krepostnoy/brain-of-infrared-rework-station/kluch_5.2d/MENU__LCD2004.pdf

0 | 1 | 2 | 3 | 4 | 5 | 6 | 7 | 8 | 9 10 11 12 13 14 15 16 17 18 19
0 | 0 | b | r | a | i | n | o | f | I | R | s | t | a | t | i | o | n
1 | 1 | | v | 1 | . | 3 | . | 3 | | | | S | P | P | i | r | s | p
2 | 2 | f | o | r | u | m | . | a | m | p | e | r | k | a | . | r | u
3 | 3 | e | v | e | r | y | o | n | e | l | o | v | e | s | c | a | t | s | !
S | t | a | t | e | : | I | D | L | E | m | > | ( | * | . | * | ) | < | m
| N | a | m | e | : | | 1 | | | S | t | e | p | : | | 1
| T | h | S | P | : | | 1 | 8 | 0 | R | e | a | l | : | | 2 | 8
| B | h | S | P | : | | 1 | 6 | 0 | R | e | a | l | : | | 2 | 8
P | r | o | f | i | l | e | : | 1 | 0 | S | t | e | p | s | : | 4
P | r | o | f | i | l | e | : | 1 | 0 | | S | t | e | p | s | : | 4
B | o | t | H | e | a | t | e | r | | T | a | r | g | e | t | : | 1 | 6 | 0
P | r | o | f | i | l | e | : | 1 | 0 | | S | t | e | p | s | : | 4
B | o | t | H | e | a | t | e | r | | T | a | r | g | e | t | : | 1 | 6 | 0
T | o | p | S | t | e | p | : | 1 | | T | a | r | g | e | t | : | 1 | 8 | 0
P | r | o | f | i | l | e | : | 1 | 0 | | S | t | e | p | s | : | 4
B | o | t | H | e | a | t | e | r | | T | a | r | g | e | t | : | 1 | 6 | 0
T | o | p | S | t | e | p | : | 1 | | | | R | a | m | p | : | 1 | . | 0
P | r | o | f | i | l | e | : | 1 | 0 | | S | t | e | p | s | : | 4
B | o | t | H | e | a | t | e | r | | T | a | r | g | e | t | : | 1 | 6 | 0
T | o | p | S | t | e | p | : | 1 | | | D | w | e | l | l | : | 1 | 0
P | r | o | f | i | l | e | : | 1 | 0 | | S | t | e | p | s | : | 4
P | . | | I | . | | D | . | | | P | a | r | a | m | e | t | e | r | s
B | o | t | H | e | a | t | e | r | | | | | k | f | 2 | : | 6 | 0

заставка при вкл. станции

главный экран

ред. число шагов в профиле (1-4)

ред. уставки НИ профиля №1 (80-330°С)

ред. уставки в шаге №1 профиля №1 (0-255°С)

ред. скорость прироста температуры в шаге профиля (0,1-3,0°С/сек)

ред. длительности удержания уставки шага профиля (0-255сек)

ПИД НИ, ред. Kf2 для LongBottomPid(0-255) НЕ ИСПОЛЬЗУЕТСЯ

P | r | o | f | i | l | e | : | 1 | 0 | | S | t | e | p | s | : | 4
P | . | | I | . | | D | . | | | P | a | r | a | m | e | t | e | r | s
B | o | t | H | e | a | t | e | r | | | | | k | f | 2 | : | 6 | 0
P | : | 6 | | | | | I | : | | | | | | D | :
P | r | o | f | i | l | e | : | 1 | 0 | | S | t | e | p | s | : | 4
P | . | | I | . | | D | . | | | P | a | r | a | m | e | t | e | r | s
B | o | t | H | e | a | t | e | r | | | | | k | f | 2 | : | 6 | 0
P | : | 6 | | | | | I | : | 2 | 0 | | | | D | :
P | r | o | f | i | l | e | : | 1 | 0 | | S | t | e | p | s | : | 4
P | . | | I | . | | D | . | | | P | a | r | a | m | e | t | e | r | s
B | o | t | H | e | a | t | e | r | | | | | k | f | 2 | : | 6 | 0
P | : | 6 | | | | | I | : | 2 | 0 | | | | D | : | 4 | 0
P | r | o | f | i | l | e | : | 1 | 0 | | S | t | e | p | s | : | 4
P | . | | I | . | | D | . | | | P | a | r | a | m | e | t | e | r | s
T | o | p | H | e | a | t | e | r
P | : | 6 | | | | | I | : | | | | | | D | :
P | r | o | f | i | l | e | : | 1 | 0 | | S | t | e | p | s | : | 4
P | . | | I | . | | D | . | | | P | a | r | a | m | e | t | e | r | s
T | o | p | H | e | a | t | e | r
P | : | 6 | | | | | I | : | 2 | 0 | | | | D | :
P | r | o | f | i | l | e | : | 1 | 0 | | S | t | e | p | s | : | 4
P | . | | I | . | | D | . | | | P | a | r | a | m | e | t | e | r | s
T | o | p | H | e | a | t | e | r
P | : | 6 | | | | | I | : | 2 | 0 | | | | D | : | 4 | 0
P | r | o | f | i | l | e | : | 1 | 0 | | S | t | e | p | s | : | 4
P | o | w | e | r | | | | P | a | r | a | m | e | t | e | r | s
B | o | t | H | e | a | t | e | r | | P | W | R | | L | i | m | i | t | s
m | i | n | : | 0 | % | | | | | | | | m | a | x | :
P | r | o | f | i | l | e | : | 1 | 0 | | S | t | e | p | s | : | 4
P | o | w | e | r | | | P | a | r | a | m | e | t | e | r | s
B | o | t | H | e | a | t | e | r | | P | W | R | | L | i | m | i | t | s
m | i | n | : | 0 | % | | | | | | | | m | a | x | : | 9 | 9 | %
P | r | o | f | i | l | e | : | 1 | 0 | S | t | e | p | s | : | 4

ПИД НИ, ред. П(0-255)

ПИД НИ, ред. И(0-255)

ПИД НИ, ред. Д(0-255)

ПИД ВИ, ред. П(0-255)

ПИД ВИ, ред. И(0-255)

ПИД ВИ, ред. Д(0-255)

ред. ограничения мин. мощности НИ(0-50%)

ред. ограничения макс. мощности НИ(0-99%)

ред. уставки преднагрева для инерционного НИ(0-100°С)

P | o | w | e | r | | | P | a | r | a | m | e | t | e | r | s
T | o | p | S | t | e | p | : | 1 | | | T | o | p | P | o | w | e | r
m | i | n | : | 7 | 0 | | | | | | | | m | a | x | :
P | r | o | f | i | l | e | : | 1 | 0 | | S | t | e | p | s | : | 4
P | o | w | e | r | | | P | a | r | a | m | e | t | e | r | s
B | o | t | H | e | a | t | e | r | | P | W | R | | L | i | m | i | t | s
m | i | n | : | 7 | 0 | | | | | | | | m | a | x | : | 9 | 0 | %
P | r | o | f | i | l | e | : | 1 | 0 | | S | t | e | p | s | : | 4
P | o | w | e | r | | | P | a | r | a | m | e | t | e | r | s
T | o | p | S | t | e | p | : | 1 | | | T | o | p | P | o | w | e | r
m | i | n | : | 0 | % | | | | | | | | m | a | x | :
P | r | o | f | i | l | e | : | 1 | 0 | | S | t | e | p | s | : | 4
P | o | w | e | r | | | P | a | r | a | m | e | t | e | r | s
B | o | t | H | e | a | t | e | r | | P | W | R | | L | i | m | i | t | s
m | i | n | : | 0 | % | | | | | | | | m | a | x | : | 9 | 9 | %
P | r | o | f | i | l | e | : | 1 | 0 | S | t | e | p | s | : | 4

ред. число шагов в профиле (1-4) ред. мощности преднагрева для инерционного НИ(0-99%)

ред. ограничения мин. мощности ВИ(0-99%) в шаге профиля

ред. ограничение макс. мощности ВИ(0-99%) в шаге профиля
