krepostnoy/brain-of-infrared-rework-station/(threads)

Thread 1 (2023-04-05):

Предупреждения при компиляции

wzooroo, 2023-04-05:
`C:\ИК станция\kluch_5.2d\kluch_5.2d.ino:41:21: warning: extra tokens at end of #ifdef directive
C:\ИК станция\kluch_5.2d\kluch_5.2d.ino:44:21: warning: extra tokens at end of #ifdef directive
In file included from C:\ИК станция\kluch_5.2d\kluch_5.2d.ino:14:0:
C:\Users\home\Documents\Arduino\libraries\ClickBtnLong/ClickBtnLong.h:11:7: warning: extra qualification 'ClickBtnLong::' on member 'VerifiClick' [-fpermissive]
  bool ClickBtnLong::VerifiClick ();
       ^~~~~~~~~~~~

In file included from C:\Users\home\Documents\Arduino\libraries\ClickBtnLong\ClickBtnLong.cpp:4:0:
C:\Users\home\Documents\Arduino\libraries\ClickBtnLong\ClickBtnLong.h:11:7: warning: extra qualification 'ClickBtnLong::' on member 'VerifiClick' [-fpermissive]
  bool ClickBtnLong::VerifiClick ();
       ^~~~~~~~~~~~
`
Компилится но предупреждает.
Это не влияет на работу?

krepostnoy, 2023-04-06:
IDE 1.8.19 "Скетч использует 17960 байт (55%) памяти устройства. Всего доступно 32256 байт.
Глобальные переменные используют 777 байт (37%) динамической памяти, оставляя 1271 байт для локальных переменных. Максимум: 2048 байт."
IDE 1.8.13 "Скетч использует 17960 байт (55%) памяти устройства. Всего доступно 32256 байт.
Глобальные переменные используют 777 байт (37%) динамической памяти, оставляя 1271 байт для локальных переменных. Максимум: 2048 байт."
В папке libraries только библиотеки из архива. Никаких предупреждений IDE не сделала. Расширенный вывод при компиляции тоже показал отсутствие предупреждений и ошибок.

Closed 2023-04-07.

Thread 2 (2023-04-07):

Ошибка в схеме?

wzooroo, 2023-04-07:
**По скетчу**

#define thermoCStop 6                             //CS MAX6675 "ВЕРХНЕГО" канала
#define thermoCSbott 7                            //CS MAX6675 "НИЖНЕГО" канала
#define thermoSO 8                                //DO=(SO) преобразователей термопар MAX6675
#define thermoCLK  9                              //SCK=(CLK) преобразователей термопар MAX6675

**по схеме**

#define thermoCStop 8                             //CS MAX6675 "ВЕРХНЕГО" канала
#define thermoCSbott 9                            //CS MAX6675 "НИЖНЕГО" канала
#define thermoSO 6                                //DO=(SO) преобразователей термопар MAX6675
#define thermoCLK  7                              //SCK=(CLK) преобразователей термопар MAX6675

или я ошибаюсь?

krepostnoy, 2023-04-07:
Благодарю за обратную связь. Исправил схему.

Closed 2023-04-07.

Thread 3 (2023-04-17):

Нет соединения(

wzooroo, 2023-04-17:
Подскажите, как подключить к irsp?
Хоть тресни прога не видит станцию(  Хотя в serial_port_plotter (не во всех версиях) графики рисует!
Я что-то делаю не так?

wzooroo, 2023-04-17:
Разобрался!
Если SPP в скетче не за комментировать то будет ошибка.

krepostnoy, 2023-04-17:
> Разобрался! Если SPP в скетче не за комментировать то будет ошибка.

Верно. Перед компиляцией, во вкладке Setting.h строку №2 нужно закомментировать, если желаете использовать ПО irsp.exe, а не SerialOortPlotter.

Closed 2023-04-17.
