krepostnoy/brain-of-infrared-rework-station/(list of files, drawings)

Other design files:
kluch_5.2d/cxema_v1.3.x.spl7
