krepostnoy/brain-of-infrared-rework-station/(commit log)

2021-08-02 Update README.md
    Добавлена информация.
2023-04-03 Add files via upload
    Версия 168c использует только 3 кнопки для управления. Клавиатура подключена к пину A5 ( для тех, у кого arduino UNO, которая не имеет пин A6). Подробное описание в файле informer.h. Описание управления контроллером - в файле MENU_v1.4.pdf.
2023-04-07 Add files via upload
    Подключение модулей MAX6675 приведено в соответствие со скетчем.
    [cxema_v1.3.x.spl7]
